dennis9819/Z80-Homebrew-Computer/schematics/Z8C rev3/file620DAC33.sch

## KiCad design schematics/Z8C rev3/file620DAC33.sch (2022-04-11)

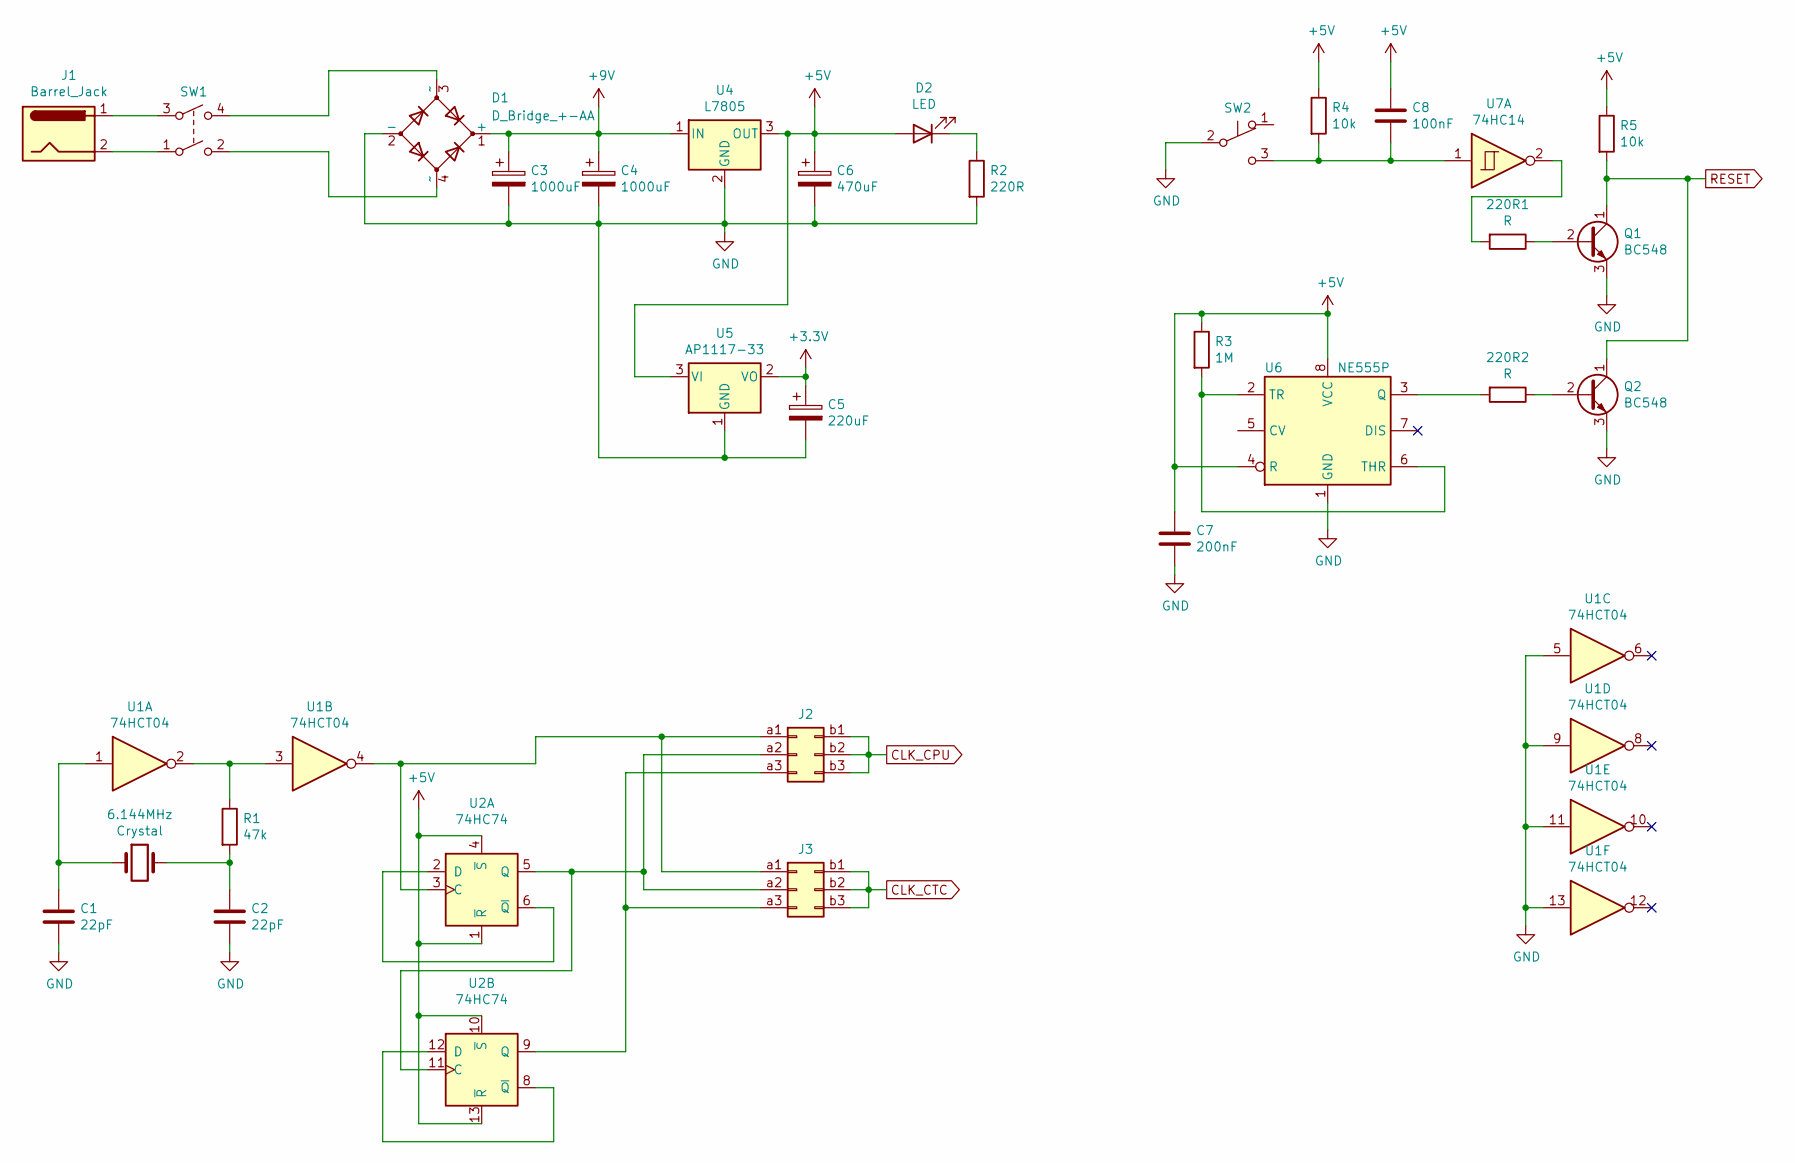
[picture p7: schematic file620DAC33.sch]

Parts:
6.144MHz: Crystal
220R1, 220R2: R
C1, C2: 22pF
C3, C4: 1000uF
C5: 220uF
C6: 470uF
C7: 200nF
C8: 100nF
D1: D_Bridge_+-AA
D2: LED
J1: Barrel_Jack; BarrelJack_CUI_PJ-063AH_Horizontal
J2, J3: Conn_02x03_Row_Letter_First; PinHeader_2x03_P2.54mm_Vertical
Q1, Q2: BC548; TO-92_Inline
R1: 47k
R2: 220R
R3: 1M
R4, R5: 10k
SW1: SW_DPST
SW2: SW_Push_SPDT
U1: 74HCT04; DIP-14_W7.62mm_LongPads
U2: 74HC74; DIP-14_W7.62mm_LongPads
U4: L7805
U5: AP1117-33; SOT-223-3_TabPin2
U6: NE555P; DIP-8_W7.62mm
U7: 74HC14; DIP-14_W7.62mm_LongPads

Connections:
+3.3V: C5.1, U5.2 (VO)
+5V: C6.1, C7.1, C8.1, D2.2 (A), R3.1, R4.1, R5.1, U2.1 (~R), U2.4 (~S), U2.10 (~S), U2.13 (~R), U4.3 (OUT), U5.3 (VI), U6.4 (R), U6.8 (VCC)
+9V: C3.1, C4.1, D1.1 (+), U4.1 (IN)
CLK_CPU: J2.b1, J2.b2, J2.b3
CLK_CTC: J3.b1, J3.b2, J3.b3
GND: C1.2, C2.2, C3.2, C4.2, C5.2, C6.2, C7.2, D1.2 (-), Q1.3 (E), Q2.3 (E), R2.2, SW2.2 (B), U1.5, U1.9, U1.11, U1.13, U4.2 (GND), U5.1 (GND), U6.1 (GND)
unnamed: 6.144MHz.1, C1.1, U1.1
unnamed: 6.144MHz.2, C2.1, R1.2
unnamed: 220R1.1, Q1.2 (B)
unnamed: 220R1.2, U7.2
unnamed: 220R2.1, Q2.2 (B)
unnamed: 220R2.2, U6.3 (Q)
unnamed: C8.2, R4.2, SW2.3 (C), U7.1
unnamed: D1.3 (~~), SW1.4
unnamed: D1.4 (~~), SW1.2
unnamed: D2.1 (K), R2.1
unnamed: J1.1, SW1.3
unnamed: J1.2, SW1.1
unnamed: J2.a1, J3.a1, U1.4, U2.3 (C)
unnamed: J2.a2, J3.a2, U2.5 (Q), U2.11 (C)
unnamed: J2.a3, J3.a3, U2.9 (Q)
unnamed: R1.1, U1.2, U1.3
unnamed: R3.2, U6.2 (TR), U6.6 (THR)
unnamed: U2.2 (D), U2.6 (~Q)
unnamed: U2.8 (~Q), U2.12 (D)
RESET: Q1.1 (C), Q2.1 (C), R5.2
