dennis9819/Z80-Homebrew-Computer/schematics/Z8C rev3/file620ED226.sch

## KiCad design schematics/Z8C rev3/file620ED226.sch (2022-04-11)

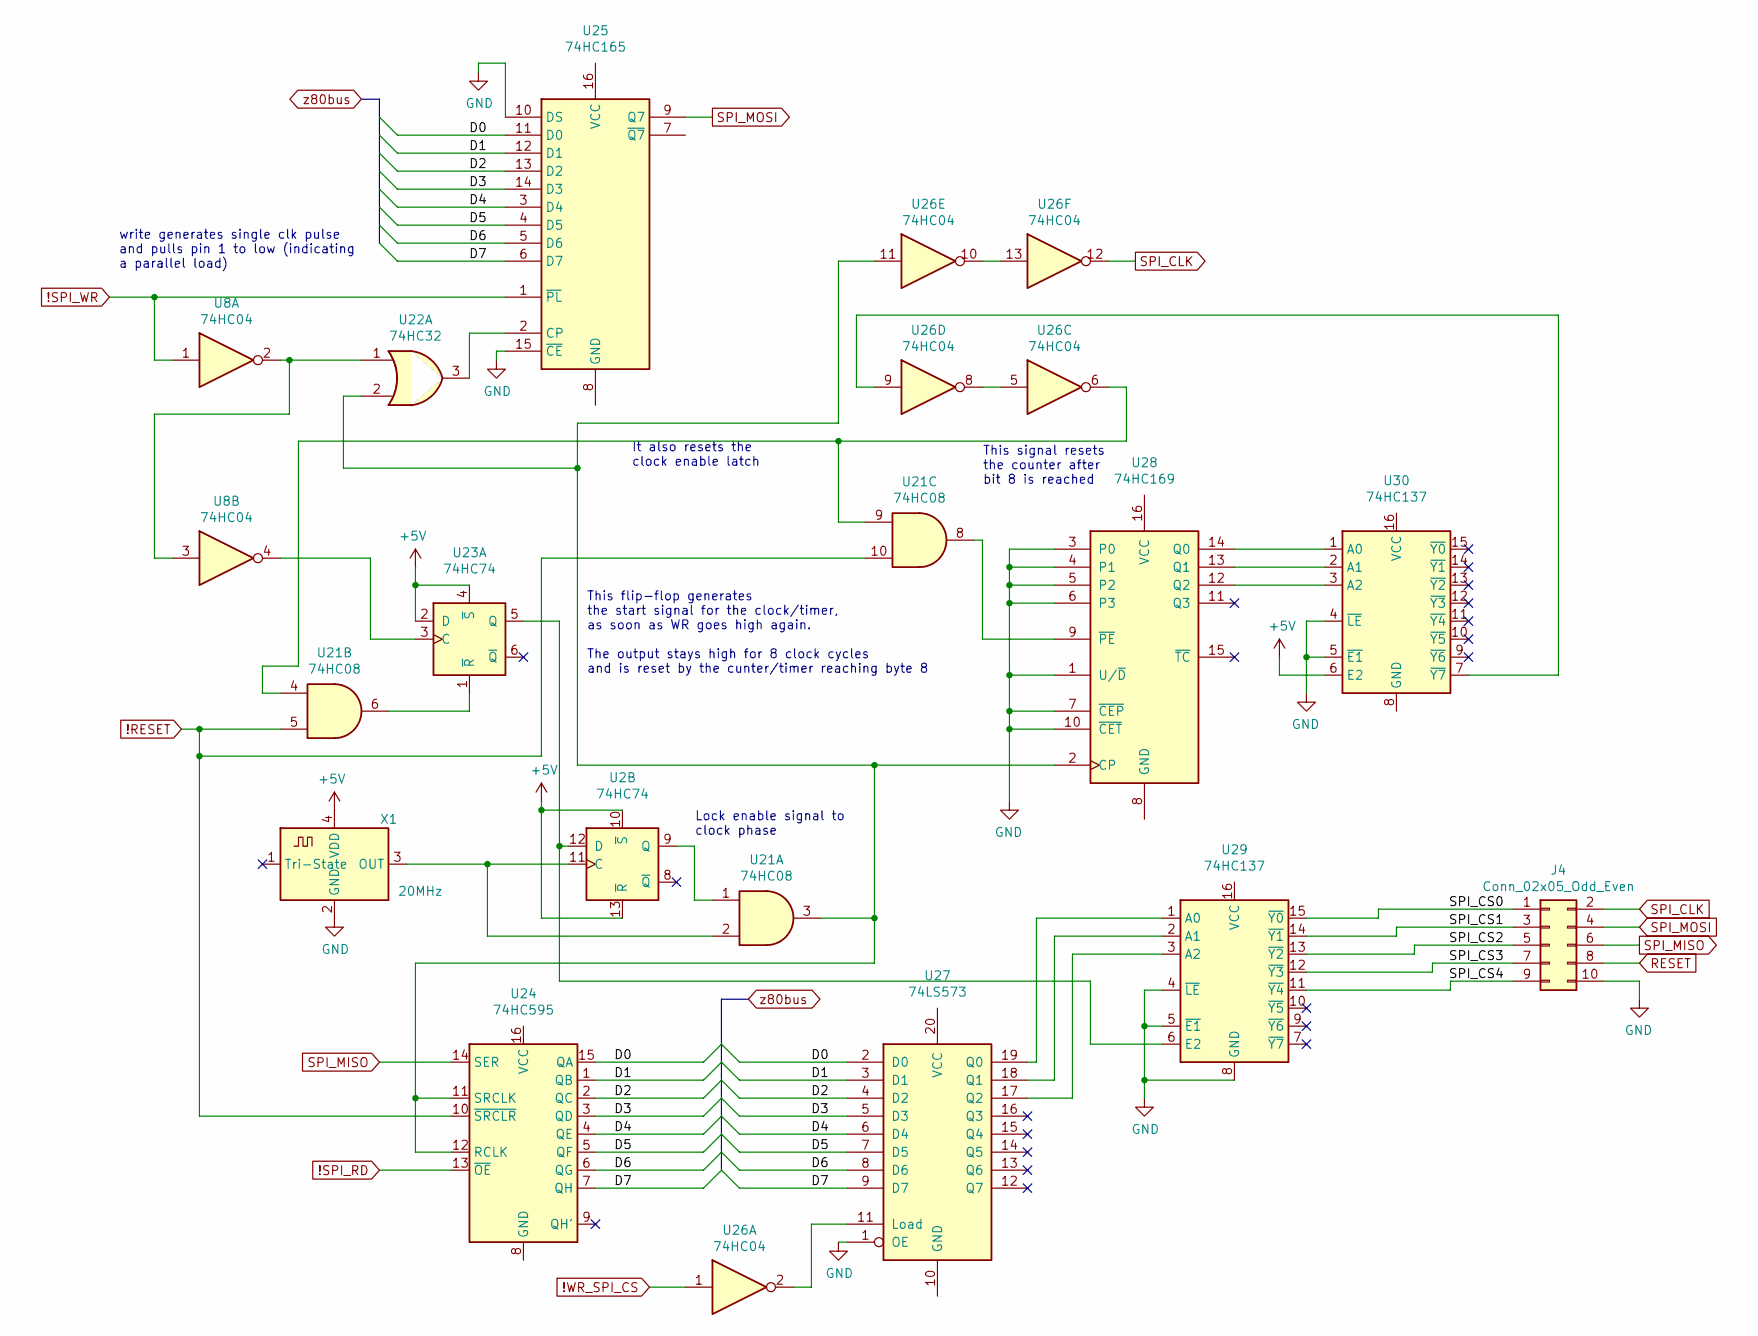
[picture p8: schematic file620ED226.sch]

Parts:
J4: Conn_02x05_Odd_Even
U2, U23: 74HC74
U8, U26: 74HC04
U21: 74HC08
U22: 74HC32
U24: 74HC595
U25: 74HC165
U27: 74LS573
U28: 74HC169
U29, U30: 74HC137
X1: 20MHz; Oscillator_SMD_Abracon_ASCO-4Pin_1.6x1.2mm

Connections:
!RESET: U21.5, U21.10, U24.10 (~SRCLR)
!SPI_RD: U24.13 (~OE)
!SPI_WR: U8.1, U25.1 (~PL)
!WR_SPI_CS: U26.1
+5V: U2.10 (~S), U2.13 (~R), U23.2 (D), U23.4 (~S), U30.6 (E2), X1.4 (VDD)
D0: U24.15 (QA), U25.11 (D0), U27.2 (D0)
D1: U24.1 (QB), U25.12 (D1), U27.3 (D1)
D2: U24.2 (QC), U25.13 (D2), U27.4 (D2)
D3: U24.3 (QD), U25.14 (D3), U27.5 (D3)
D4: U24.4 (QE), U25.3 (D4), U27.6 (D4)
D5: U24.5 (QF), U25.4 (D5), U27.7 (D5)
D6: U24.6 (QG), U25.5 (D6), U27.8 (D6)
D7: U24.7 (QH), U25.6 (D7), U27.9 (D7)
GND: J4.10, U25.10 (DS), U25.15 (~CE), U27.1 (OE), U28.1 (U/~D), U28.3 (P0), U28.4 (P1), U28.5 (P2), U28.6 (P3), U28.7 (~CEP), U28.10 (~CET), U29.4 (~LE), U29.5 (~E1), U29.8 (GND), U30.4 (~LE), U30.5 (~E1), X1.2 (GND)
unnamed: U2.9 (Q), U21.1
unnamed: U2.11 (C), U21.2, X1.3 (OUT)
unnamed: U2.12 (D), U23.5 (Q), U29.6 (E2)
unnamed: U21.3, U22.2, U24.11 (SRCLK), U24.12 (RCLK), U26.11, U28.2 (CP)
unnamed: U21.4, U21.9, U26.6
unnamed: U21.6, U23.1 (~R)
unnamed: U21.8, U28.9 (~PE)
unnamed: U8.2, U8.3, U22.1
unnamed: U22.3, U25.2 (CP)
unnamed: U8.4, U23.3 (C)
unnamed: U26.2, U27.11 (Load)
unnamed: U26.5, U26.8
unnamed: U26.9, U30.7 (~Y7)
unnamed: U26.10, U26.13
unnamed: U27.17 (Q2), U29.3 (A2)
unnamed: U27.18 (Q1), U29.2 (A1)
unnamed: U27.19 (Q0), U29.1 (A0)
unnamed: U28.12 (Q2), U30.3 (A2)
unnamed: U28.13 (Q1), U30.2 (A1)
unnamed: U28.14 (Q0), U30.1 (A0)
RESET: J4.8
SPI_CLK: J4.2, U26.12
SPI_CS0: J4.1, U29.15 (~Y0)
SPI_CS1: J4.3, U29.14 (~Y1)
SPI_CS2: J4.5, U29.13 (~Y2)
SPI_CS3: J4.7, U29.12 (~Y3)
SPI_CS4: J4.9, U29.11 (~Y4)
SPI_MISO: J4.6, U24.14 (SER)
SPI_MOSI: J4.4, U25.9 (Q7)

Notes on the sheet:
write generates single clk pulse and pulls pin 1 to low (indicating a parallel load)
This flip-flop generates the start signal for the clock/timer, as soon as WR goes high again. The output stays high for 8 clock cycles and is reset by the cunter/timer reaching byte 8
Lock enable signal to clock phase
This signal resets the counter after bit 8 is reached
It also resets the clock enable latch
