dennis9819/Z80-Homebrew-Computer/schematics/Z8C rev3/file620F0304.sch

## KiCad design schematics/Z8C rev3/file620F0304.sch (2022-04-11)

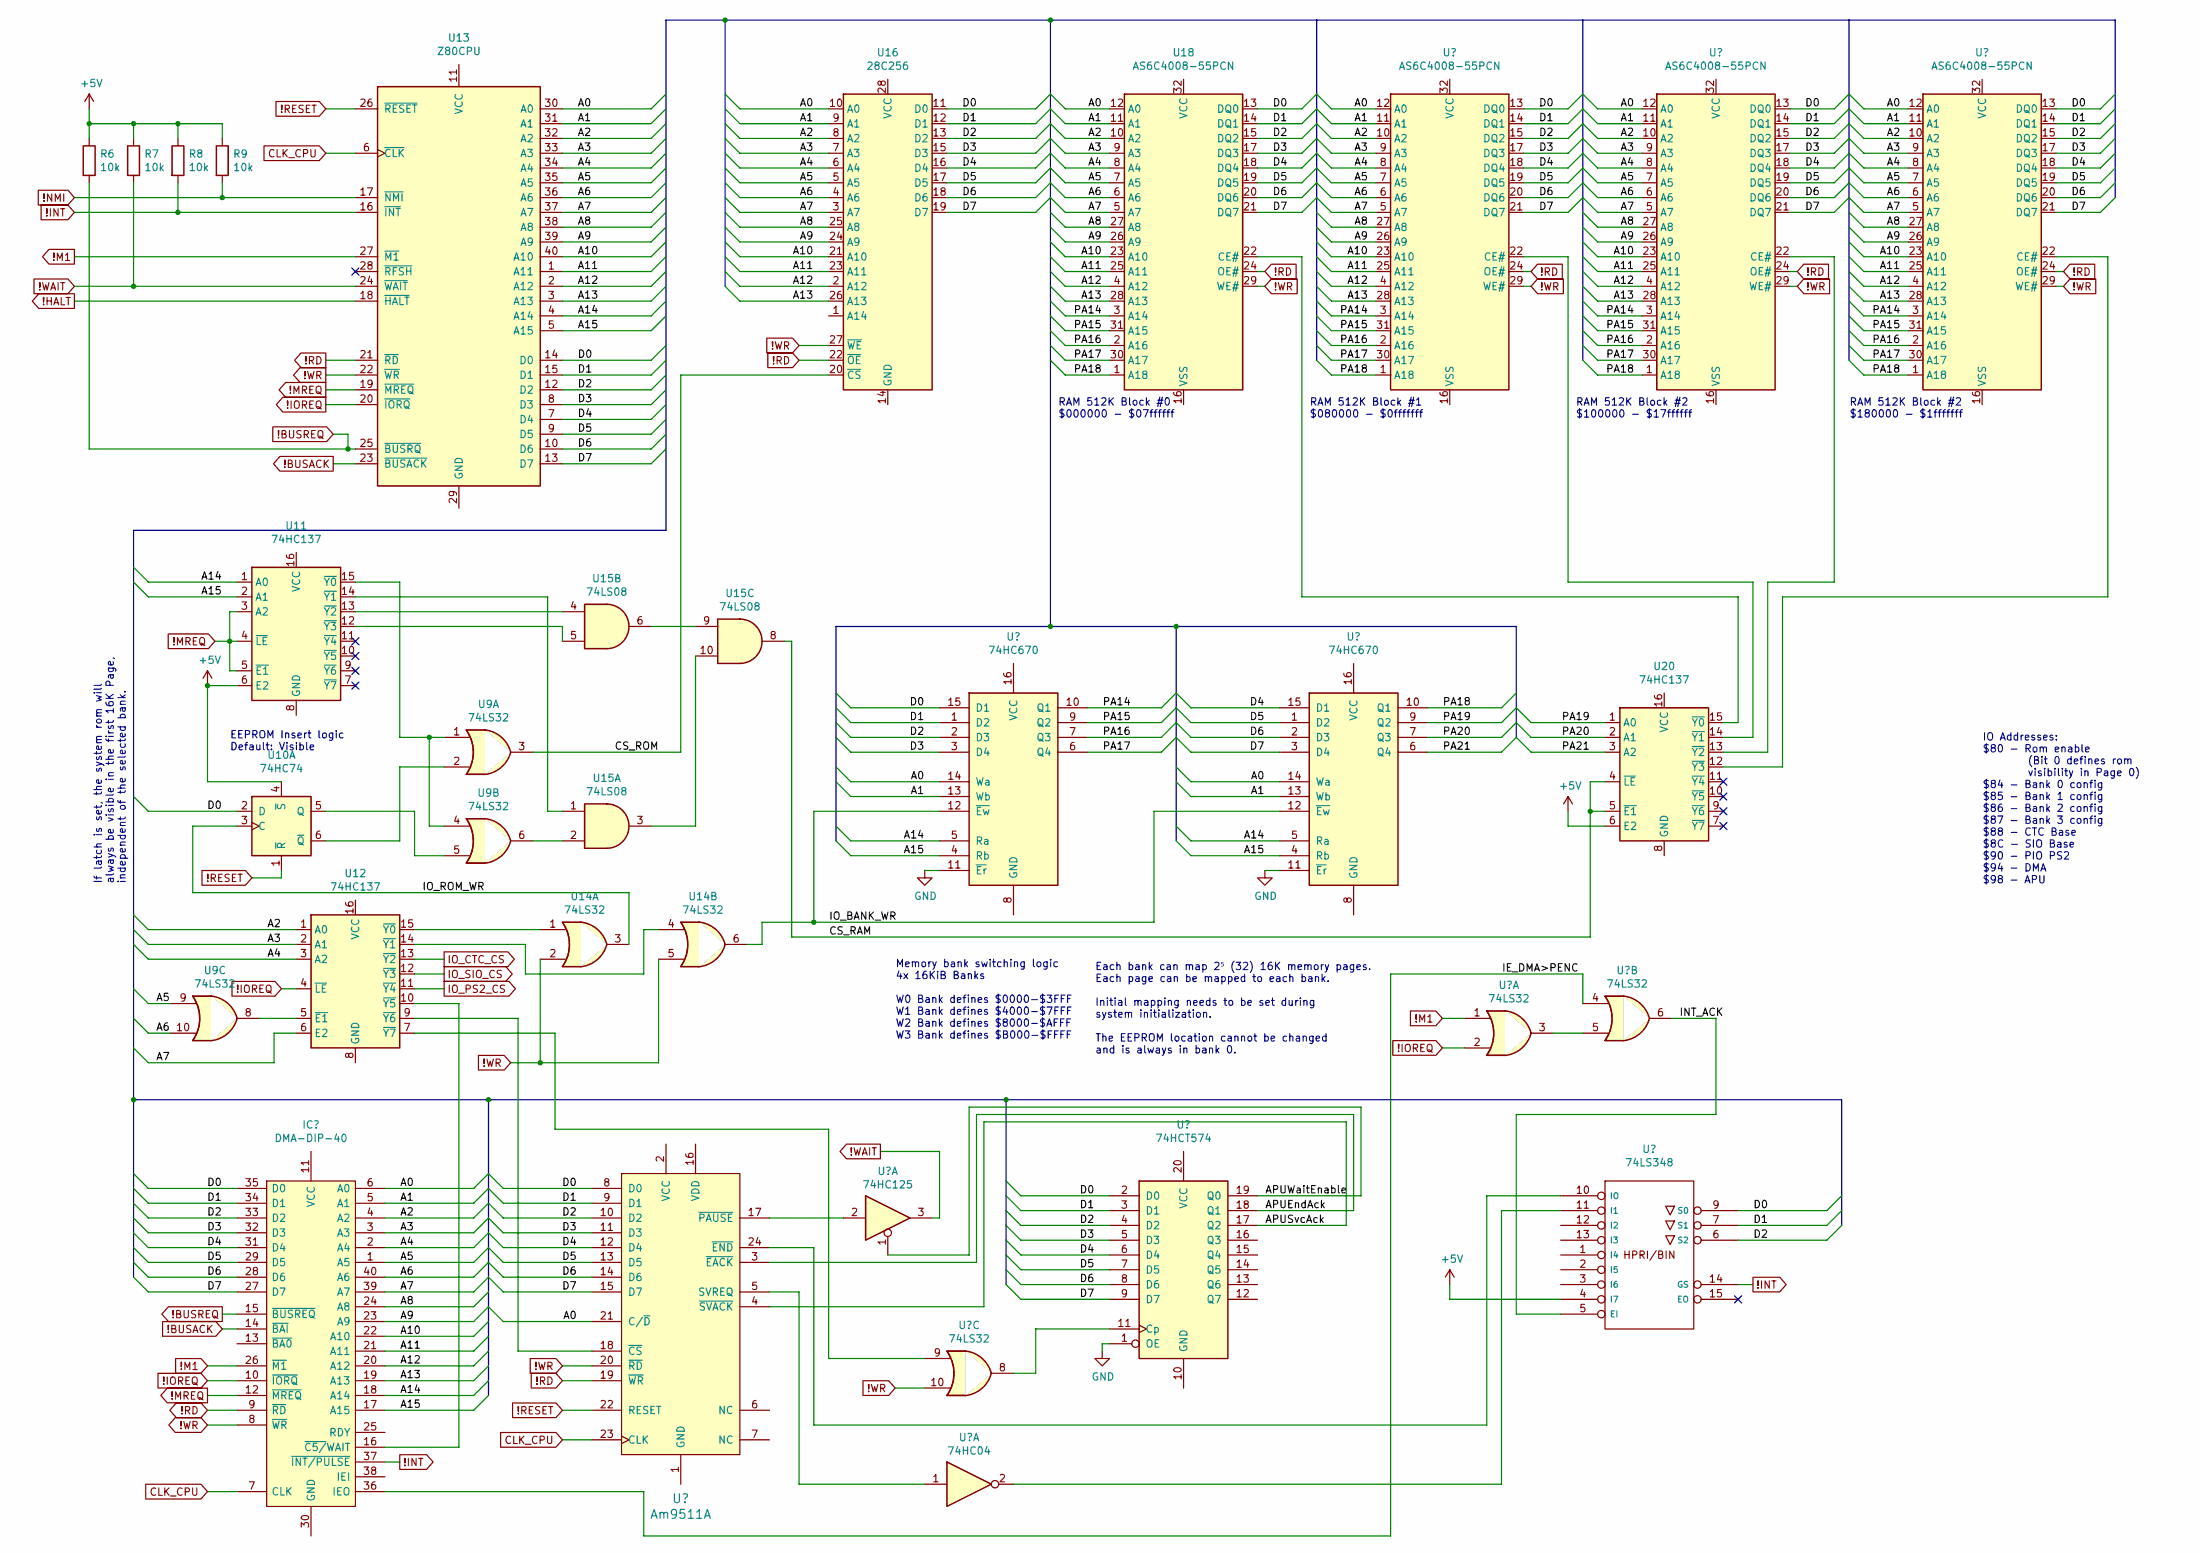
[picture p9: schematic file620F0304.sch]

Parts:
R6, R7, R8, R9: 10k
U9, U14: 74LS32; DIP-14_W7.62mm_LongPads
U10: 74HC74; DIP-14_W7.62mm_LongPads
U11, U12, U20: 74HC137; DIP-14_W7.62mm_LongPads
U13: Z80CPU; DIP-40_W15.24mm_LongPads
U15: 74LS08; DIP-14_W7.62mm_LongPads
U16: 28C256; DIP-28_W15.24mm_LongPads
U18: AS6C4008-55PCN; DIP-32_W15.24mm

Connections:
!BUSACK: U13.23 (~BUSACK~)
!BUSREQ: R6.2, U13.25 (~BUSRQ~)
!HALT: U13.18 (~HALT~)
!INT: R8.2, U13.16 (~INT~)
!IOREQ: U12.4 (~LE), U13.20 (~IORQ~)
!M1: U13.27 (~M1~)
!MREQ: U11.3 (A2), U11.4 (~LE), U11.5 (~E1), U13.19 (~MREQ~)
!NMI: R9.2, U13.17 (~NMI~)
!RD: U13.21 (~RD~), U16.22 (~OE), U18.24 (OE#)
!RESET: U10.1 (~R), U13.26 (~RESET~)
!WAIT: R7.2, U13.24 (~WAIT~)
!WR: U13.22 (~WR~), U14.2, U14.5, U16.27 (~WE), U18.29 (WE#)
+5V: R6.1, R7.1, R8.1, R9.1, U10.4 (~S), U11.6 (E2), U20.6 (E2)
A0: U13.30 (A0), U16.10 (A0), U18.12 (A0)
A1: U13.31 (A1), U16.9 (A1), U18.11 (A1)
A2: U12.1 (A0), U13.32 (A2), U16.8 (A2), U18.10 (A2)
A3: U12.2 (A1), U13.33 (A3), U16.7 (A3), U18.9 (A3)
A4: U12.3 (A2), U13.34 (A4), U16.6 (A4), U18.8 (A4)
A5: U9.9, U13.35 (A5), U16.5 (A5), U18.7 (A5)
A6: U9.10, U13.36 (A6), U16.4 (A6), U18.6 (A6)
A7: U12.6 (E2), U13.37 (A7), U16.3 (A7), U18.5 (A7)
A8: U13.38 (A8), U16.25 (A8), U18.27 (A8)
A9: U13.39 (A9), U16.24 (A9), U18.26 (A9)
A10: U13.40 (A10), U16.21 (A10), U18.23 (A10)
A11: U13.1 (A11), U16.23 (A11), U18.25 (A11)
A12: U13.2 (A12), U16.2 (A12), U18.4 (A12)
A13: U13.3 (A13), U16.26 (A13), U18.28 (A13)
A14: U11.1 (A0), U13.4 (A14)
A15: U11.2 (A1), U13.5 (A15)
CLK_CPU: U13.6 (~CLK~)
CS_RAM: U15.8, U20.4 (~LE), U20.5 (~E1)
CS_ROM: U9.3, U16.20 (~CS)
D0: U10.2 (D), U13.14 (D0), U16.11 (D0), U18.13 (DQ0)
D1: U13.15 (D1), U16.12 (D1), U18.14 (DQ1)
D2: U13.12 (D2), U16.13 (D2), U18.15 (DQ2)
D3: U13.8 (D3), U16.15 (D3), U18.17 (DQ3)
D4: U13.7 (D4), U16.16 (D4), U18.18 (DQ4)
D5: U13.9 (D5), U16.17 (D5), U18.19 (DQ5)
D6: U13.10 (D6), U16.18 (D6), U18.20 (DQ6)
D7: U13.13 (D7), U16.19 (D7), U18.21 (DQ7)
IO_BANK_WR: U14.6
IO_CTC_CS: U12.13 (~Y2)
IO_PS2_CS: U12.11 (~Y4)
IO_ROM_WR: U10.3 (C), U14.3
IO_SIO_CS: U12.12 (~Y3)
unnamed: U9.5, U10.5 (Q)
unnamed: U9.2, U10.6 (~Q)
unnamed: U11.12 (~Y3), U15.5
unnamed: U11.13 (~Y2), U15.4
unnamed: U11.14 (~Y1), U15.1
unnamed: U9.1, U9.4, U11.15 (~Y0)
unnamed: U9.8, U12.5 (~E1)
unnamed: U12.14 (~Y1), U14.4
unnamed: U12.15 (~Y0), U14.1
unnamed: U9.6, U15.2
unnamed: U15.6, U15.9
unnamed: U15.3, U15.10
unnamed: U18.22 (CE#), U20.15 (~Y0)
PA14: U18.3 (A14)
PA15: U18.31 (A15)
PA16: U18.2 (A16)
PA17: U18.30 (A17)
PA18: U18.1 (A18)
PA19: U20.1 (A0)
PA20: U20.2 (A1)
PA21: U20.3 (A2)

Notes on the sheet:
Memory bank switching logic 4x 16KiB Banks W0 Bank defines $0000-$3FFF W1 Bank defines $4000-$7FFF W2 Bank defines $8000-$AFFF W3 Bank defines $B000-$FFFF
If latch is set, the system rom will always be visible in the first 16K Page, independent of the selected bank.
Each bank can map 2⁵ (32) 16K memory pages. Each page can be mapped to each bank. Initial mapping needs to be set during system initialization. The EEPROM location cannot be changed and is always in bank 0.
IO Addresses: $80 - Rom enable (Bit 0 defines rom visibility in Page 0) $84 - Bank 0 config $85 - Bank 1 config $86 - Bank 2 config $87 - Bank 3 config $88 - CTC Base $8C - SIO Base $90 - PIO PS2 $94 - DMA $98 - APU
EEPROM Insert logic Default: Visible
RAM 512K Block #0 $000000 - $07ffffff
RAM 512K Block #1 $080000 - $0fffffff
RAM 512K Block #2 $100000 - $17ffffff
RAM 512K Block #2 $180000 - $1fffffff
