dennis9819/Z80-Homebrew-Computer/schematics/Z8C rev3/file62109D9A.sch

## KiCad design schematics/Z8C rev3/file62109D9A.sch (2022-04-11)

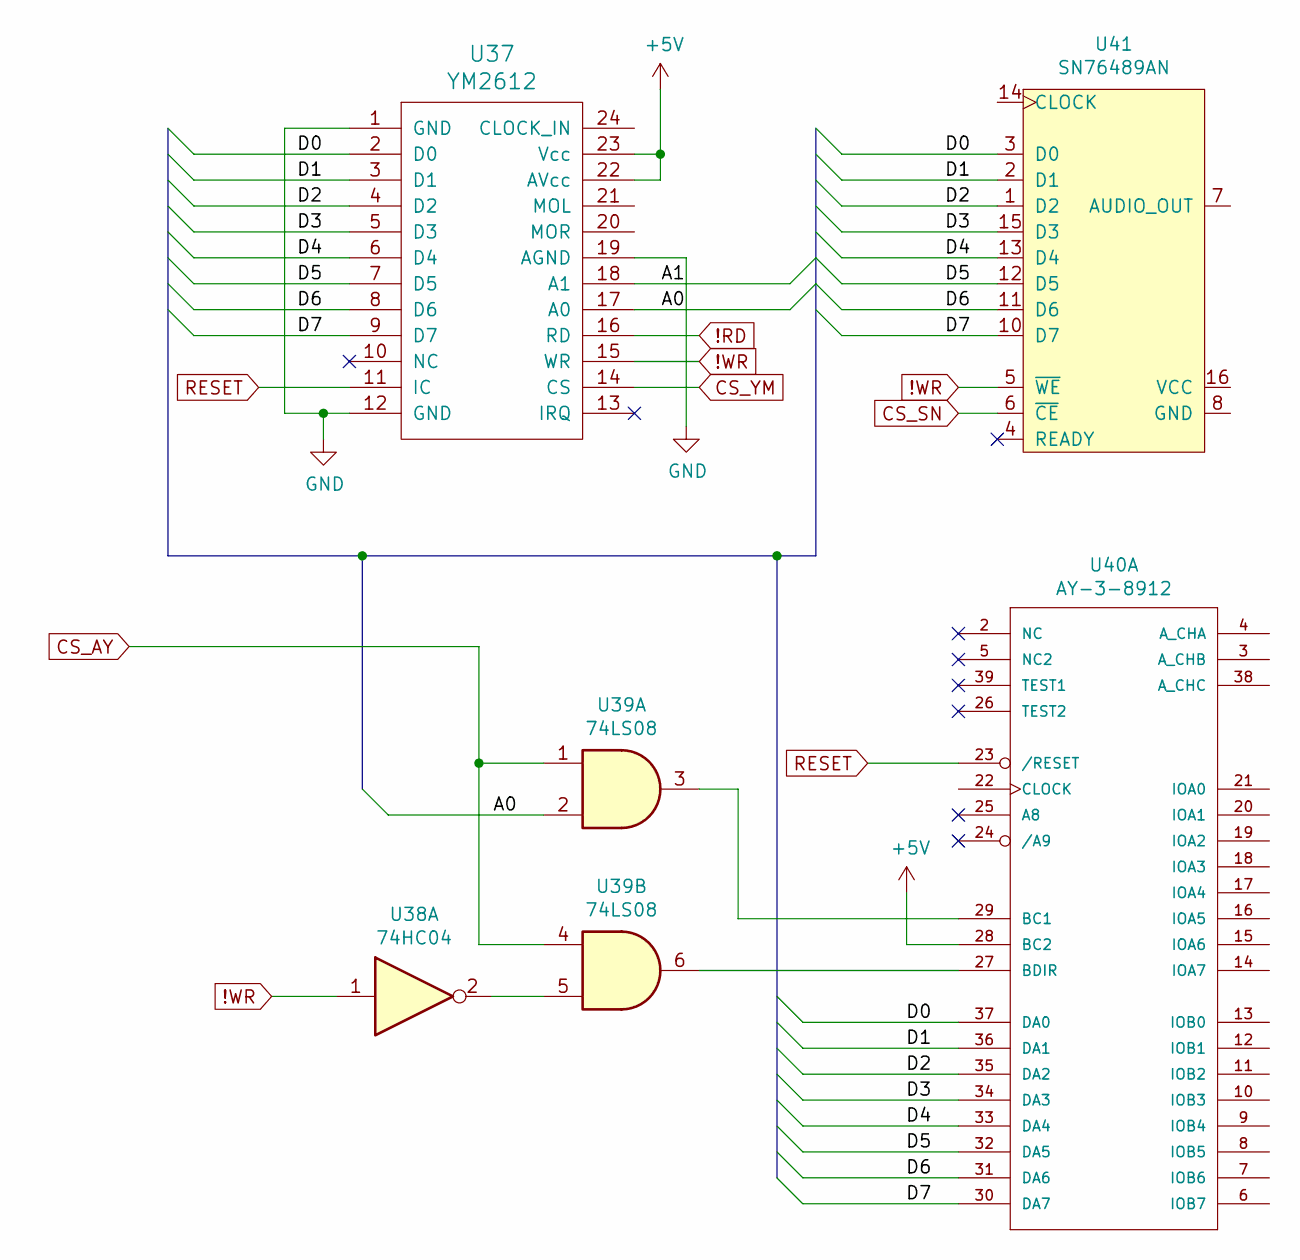
[picture p10: schematic file62109D9A.sch]

Parts:
U37: YM2612
U38: 74HC04
U39: 74LS08
U40: AY-3-8912; oldchips-DIL40
U41: SN76489AN; DIP-16_W7.62mm

Connections:
!RD: U37.16 (RD)
!WR: U37.15 (WR), U38.1, U41.5 (~WE)
+5V: U37.22 (AVcc), U37.23 (Vcc), U40.28 (BC2)
A0: U37.17 (A0), U39.2
A1: U37.18 (A1)
CS_AY: U39.1, U39.4
CS_SN: U41.6 (~CE)
CS_YM: U37.14 (CS)
D0: U37.2 (D0), U40.37 (DA0), U41.3 (D0)
D1: U37.3 (D1), U40.36 (DA1), U41.2 (D1)
D2: U37.4 (D2), U40.35 (DA2), U41.1 (D2)
D3: U37.5 (D3), U40.34 (DA3), U41.15 (D3)
D4: U37.6 (D4), U40.33 (DA4), U41.13 (D4)
D5: U37.7 (D5), U40.32 (DA5), U41.12 (D5)
D6: U37.8 (D6), U40.31 (DA6), U41.11 (D6)
D7: U37.9 (D7), U40.30 (DA7), U41.10 (D7)
GND: U37.1 (GND), U37.12 (GND), U37.19 (AGND)
unnamed: U38.2, U39.5
unnamed: U39.3, U40.29 (BC1)
unnamed: U39.6, U40.27 (BDIR)
RESET: U37.11 (IC), U40.23 (/RESET)
