dennis9819/Z80-Homebrew-Computer/schematics/Z8C rev3/file622409DB.sch

## KiCad design schematics/Z8C rev3/file622409DB.sch (2022-04-11)

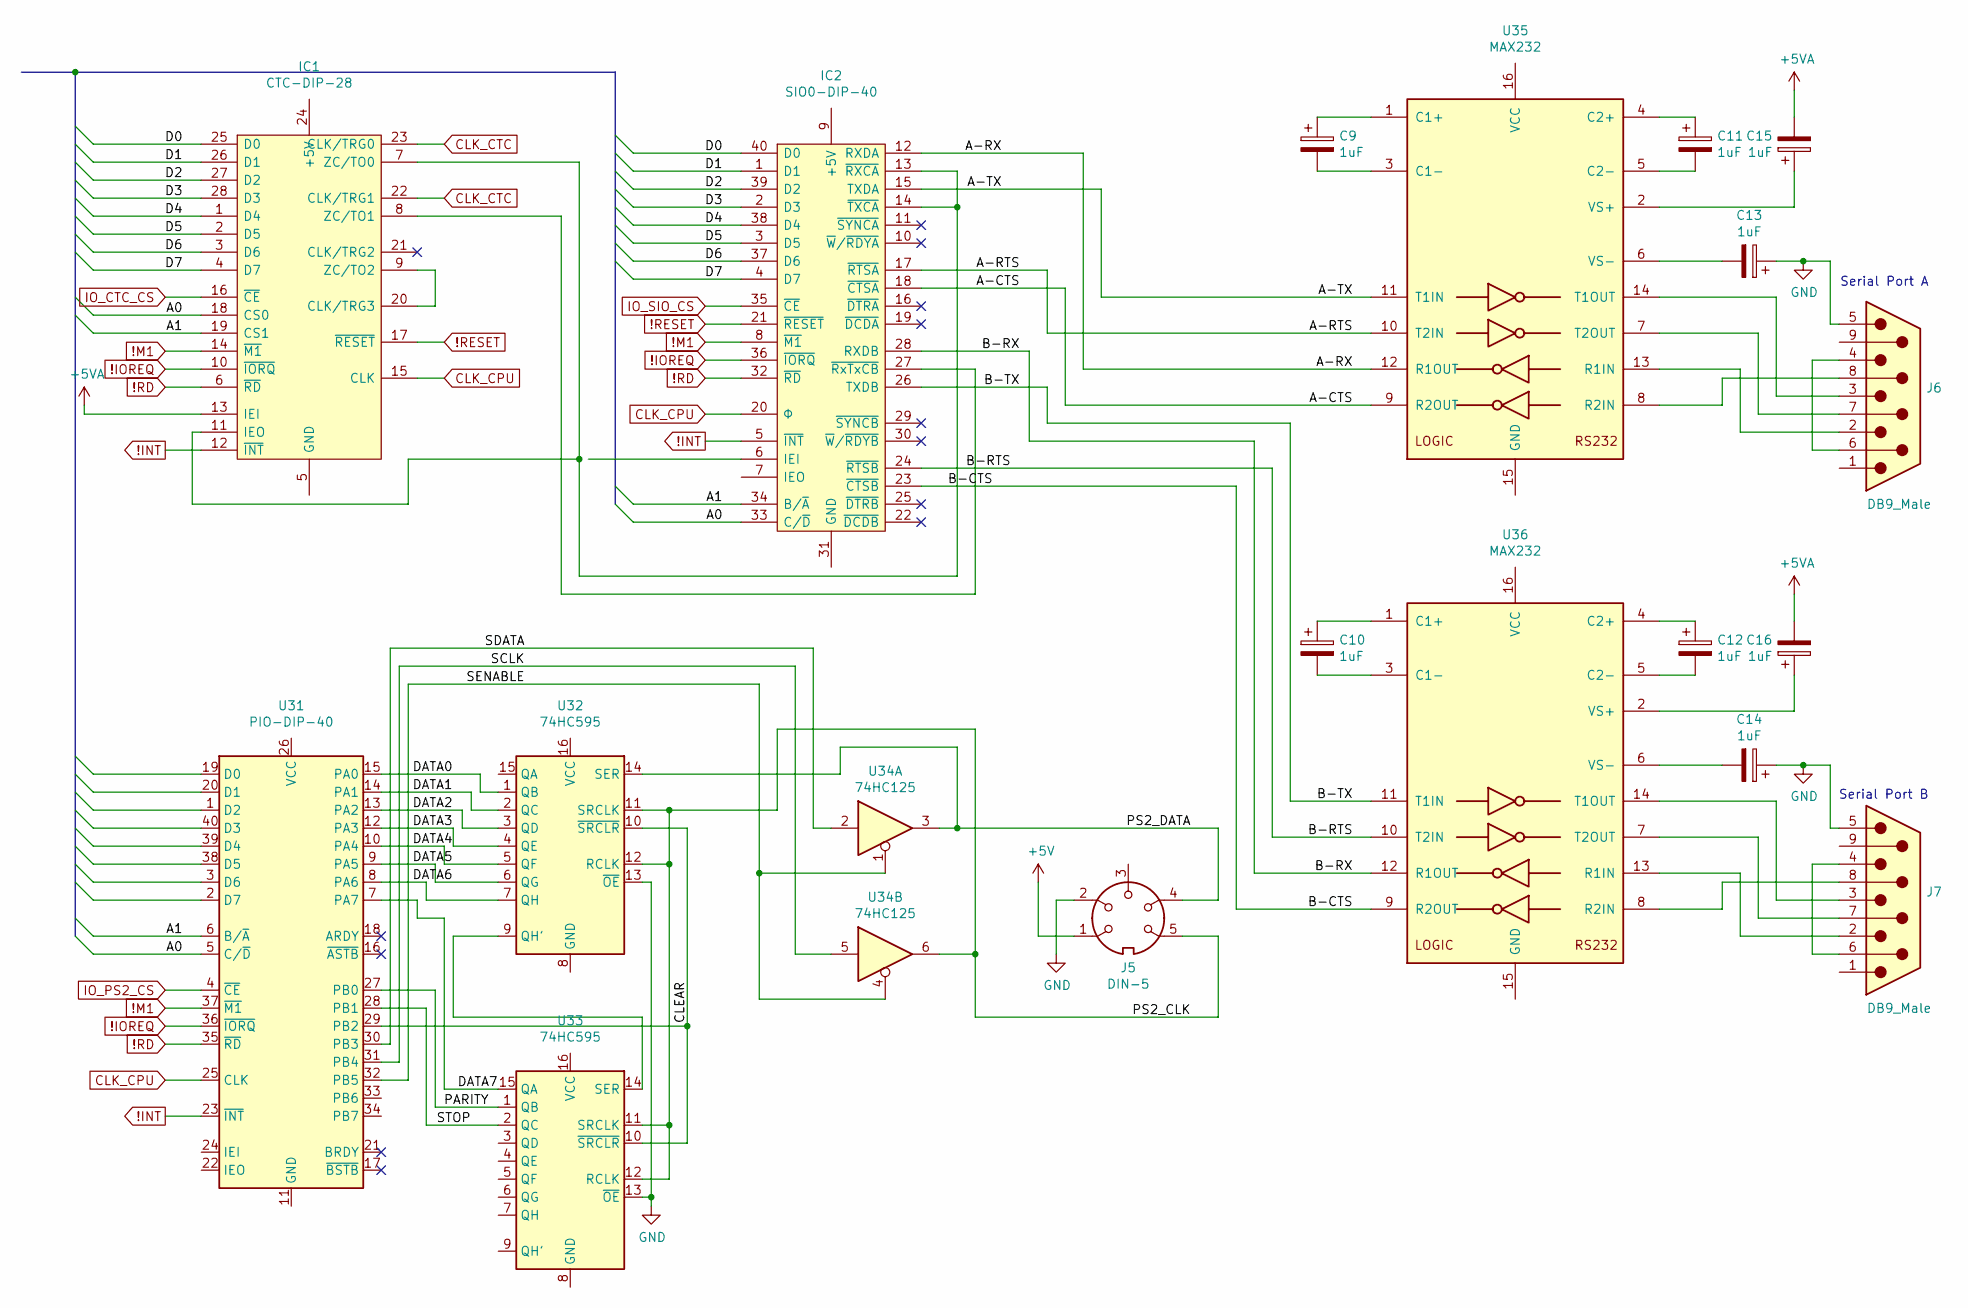
[picture p11: schematic file622409DB.sch]

Parts:
C9, C10, C11, C12, C13, C14, C15, C16: 1uF
IC1: CTC-DIP-28; DIP-28_W15.24mm_LongPads; Manufacturer_Part_Number Z84C3010PEG; Mouser Part Number 692-Z84C3010PEG
IC2: SIO0-DIP-40; DIP-40_W15.24mm_LongPads; Manufacturer_Part_Number Z84C4206PEG; Mouser Part Number 692-Z84C4206PEG
J5: DIN-5
J6, J7: DB9_Male
U31: PIO-DIP-40; DIP-40_W15.24mm
U32, U33: 74HC595; DIP-14_W7.62mm_LongPads
U34: 74HC125; DIP-14_W7.62mm_LongPads
U35, U36: MAX232; DIP-14_W7.62mm_LongPads

Connections:
!INT: IC1.12 (~INT), IC2.5 (~INT), U31.23 (~INT~)
!IOREQ: IC1.10 (~IORQ), IC2.36 (~IORQ), U31.36 (~IORQ~)
!M1: IC1.14 (~M1), IC2.8 (~M1), U31.37 (~M1~)
!RD: IC1.6 (~RD), IC2.32 (~RD), U31.35 (~RD~)
!RESET: IC1.17 (~RESET), IC2.21 (~RESET)
+5V: J5.1
+5VA: C15.2, C16.2, IC1.13 (IEI)
A0: IC1.18 (CS0), IC2.33 (C/~D), U31.5 (C/~D~)
A1: IC1.19 (CS1), IC2.34 (B/~A), U31.6 (B/~A~)
A-CTS: IC2.18 (~CTSA), U35.9 (R2OUT)
A-RTS: IC2.17 (~RTSA), U35.10 (T2IN)
A-RX: IC2.12 (RXDA), U35.12 (R1OUT)
A-TX: IC2.15 (TXDA), U35.11 (T1IN)
B-CTS: IC2.23 (~CTSB), U36.9 (R2OUT)
B-RTS: IC2.24 (~RTSB), U36.10 (T2IN)
B-RX: IC2.28 (RXDB), U36.12 (R1OUT)
B-TX: IC2.26 (TXDB), U36.11 (T1IN)
CLEAR: U31.29 (PB2), U32.10 (~SRCLR), U33.10 (~SRCLR)
CLK_CPU: IC1.15 (CLK), IC2.20 (Φ), U31.25 (CLK)
CLK_CTC: IC1.22 (CLK/TRG1), IC1.23 (CLK/TRG0)
D0: IC1.25 (D0), IC2.40 (D0)
D1: IC1.26 (D1), IC2.1 (D1)
D2: IC1.27 (D2), IC2.39 (D2)
D3: IC1.28 (D3), IC2.2 (D3)
D4: IC1.1 (D4), IC2.38 (D4)
D5: IC1.2 (D5), IC2.3 (D5)
D6: IC1.3 (D6), IC2.37 (D6)
D7: IC1.4 (D7), IC2.4 (D7)
DATA0: U31.15 (PA0), U32.1 (QB)
DATA1: U31.14 (PA1), U32.2 (QC)
DATA2: U31.13 (PA2), U32.3 (QD)
DATA3: U31.12 (PA3), U32.4 (QE)
DATA5: U31.10 (PA4), U32.5 (QF)
DATA6: U31.9 (PA5), U32.6 (QG)
DATA7: U31.7 (PA7), U33.15 (QA)
GND: C13.1, C14.1, J5.2, J6.5, J7.5, U32.13 (~OE), U33.13 (~OE)
IO_CTC_CS: IC1.16 (~CE)
IO_PS2_CS: U31.4 (~CE~)
IO_SIO_CS: IC2.35 (~CE)
unnamed: C9.1, U35.1 (C1+)
unnamed: C9.2, U35.3 (C1-)
unnamed: C10.1, U36.1 (C1+)
unnamed: C10.2, U36.3 (C1-)
unnamed: C11.1, U35.4 (C2+)
unnamed: C11.2, U35.5 (C2-)
unnamed: C12.1, U36.4 (C2+)
unnamed: C12.2, U36.5 (C2-)
unnamed: C13.2, U35.6 (VS-)
unnamed: C14.2, U36.6 (VS-)
unnamed: C15.1, U35.2 (VS+)
unnamed: C16.1, U36.2 (VS+)
unnamed: IC1.8 (ZC/TO1), IC2.27 (~RxTxCB)
unnamed: IC1.7 (ZC/TO0), IC1.11 (IEO), IC2.13 (~RXCA), IC2.14 (~TXCA)
unnamed: IC1.9 (ZC/TO2), IC1.20 (CLK/TRG3)
unnamed: J6.2, U35.13 (R1IN)
unnamed: J6.3, U35.14 (T1OUT)
unnamed: J6.4, J6.6
unnamed: J6.7, U35.7 (T2OUT)
unnamed: J6.8, U35.8 (R2IN)
unnamed: J7.2, U36.13 (R1IN)
unnamed: J7.3, U36.14 (T1OUT)
unnamed: J7.4, J7.6
unnamed: J7.7, U36.7 (T2OUT)
unnamed: J7.8, U36.8 (R2IN)
unnamed: U31.8 (PA6), U32.7 (QH)
unnamed: U32.9 (QH'), U33.14 (SER)
PARITY: U31.27 (PB0), U33.1 (QB)
PS2_CLK: J5.5, U32.11 (SRCLK), U32.12 (RCLK), U33.11 (SRCLK), U33.12 (RCLK), U34.6
PS2_DATA: J5.4, U32.14 (SER), U34.3
SCLK: U31.31 (PB4), U34.5
SDATA: U31.30 (PB3), U34.2
SENABLE: U31.32 (PB5), U34.1, U34.4
STOP: U31.28 (PB1), U33.2 (QC)

Notes on the sheet:
Serial Port A
Serial Port B
