dennis9819/Z80-Homebrew-Computer/(commit log)

2022-02-18 started schematics
    [Z8C rev3.kicad_pcb, Z8C rev3.sch, file620DAC33.sch, file620ED226.sch, file620F0304.sch, file622409DB.sch, file624F3E6E.sch]
2022-02-19 working on sound
    [Z8C rev3.sch, file620DAC33.sch, file620ED226.sch, file620F0304.sch, file62109D9A.sch, file622409DB.sch, file624F3E6E.sch]
2022-02-20 added bank switching, apu, dma and IRQ logic. Misc. improvements
    [Z8C rev3.sch, file620DAC33.sch, file620ED226.sch, file620F0304.sch, file62109D9A.sch, file622409DB.sch, file624F3E6E.sch, file63668A69.sch]
2022-04-11 intital vdp working
    [Z8C rev3.kicad_pcb]
